ElectronicCats/badge_JSCON_2026/hardware/Footprints/3D/2479--3DModel-STEP-630548.STEP

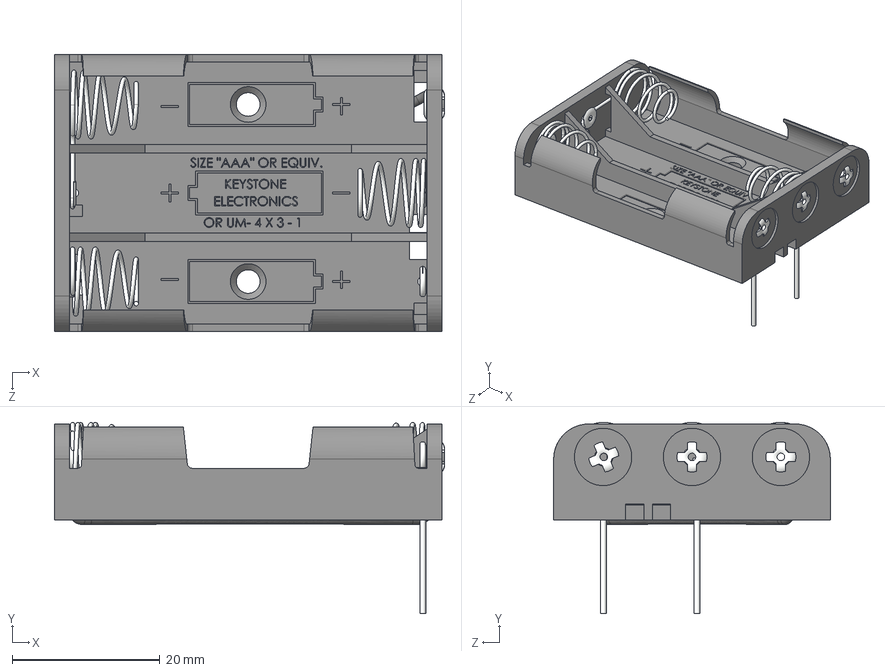
[picture p3: CAD file, 2026-06-18]
hardware/Footprints/3D/2479--3DModel-STEP-630548.STEP
52.9 x 25.9 x 37.5 mm
