ElectronicCats/badge_JSCON_2026/hardware/Badge_JSCON_2026.kicad_pcb

## KiCad design hardware/Badge_JSCON_2026.kicad_pcb (2026-06-30)

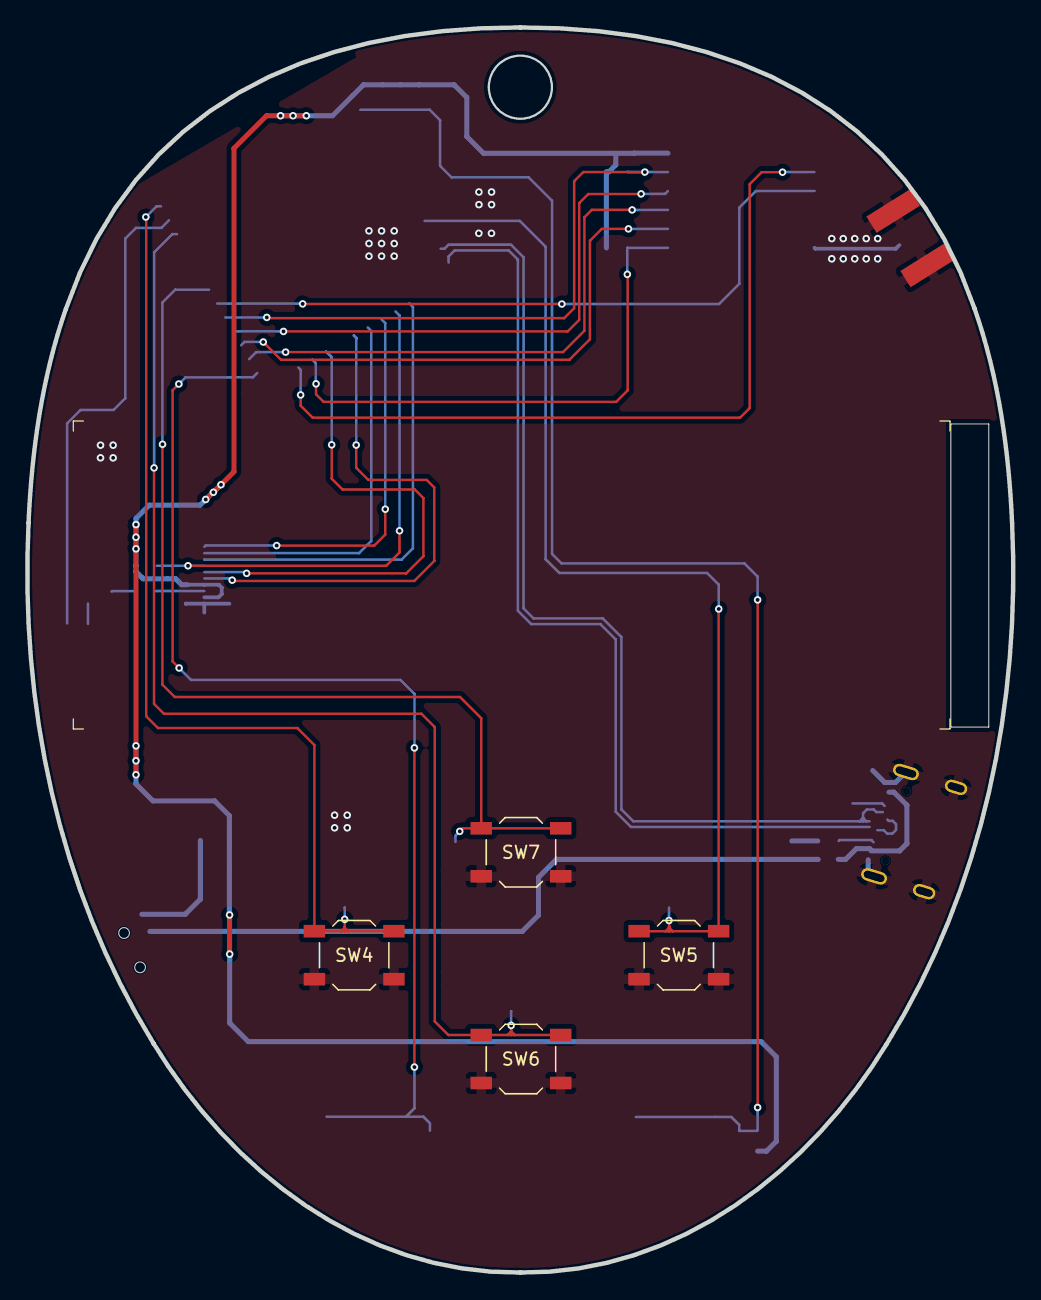
[picture p4: board Badge_JSCON_2026.kicad_pcb from above]

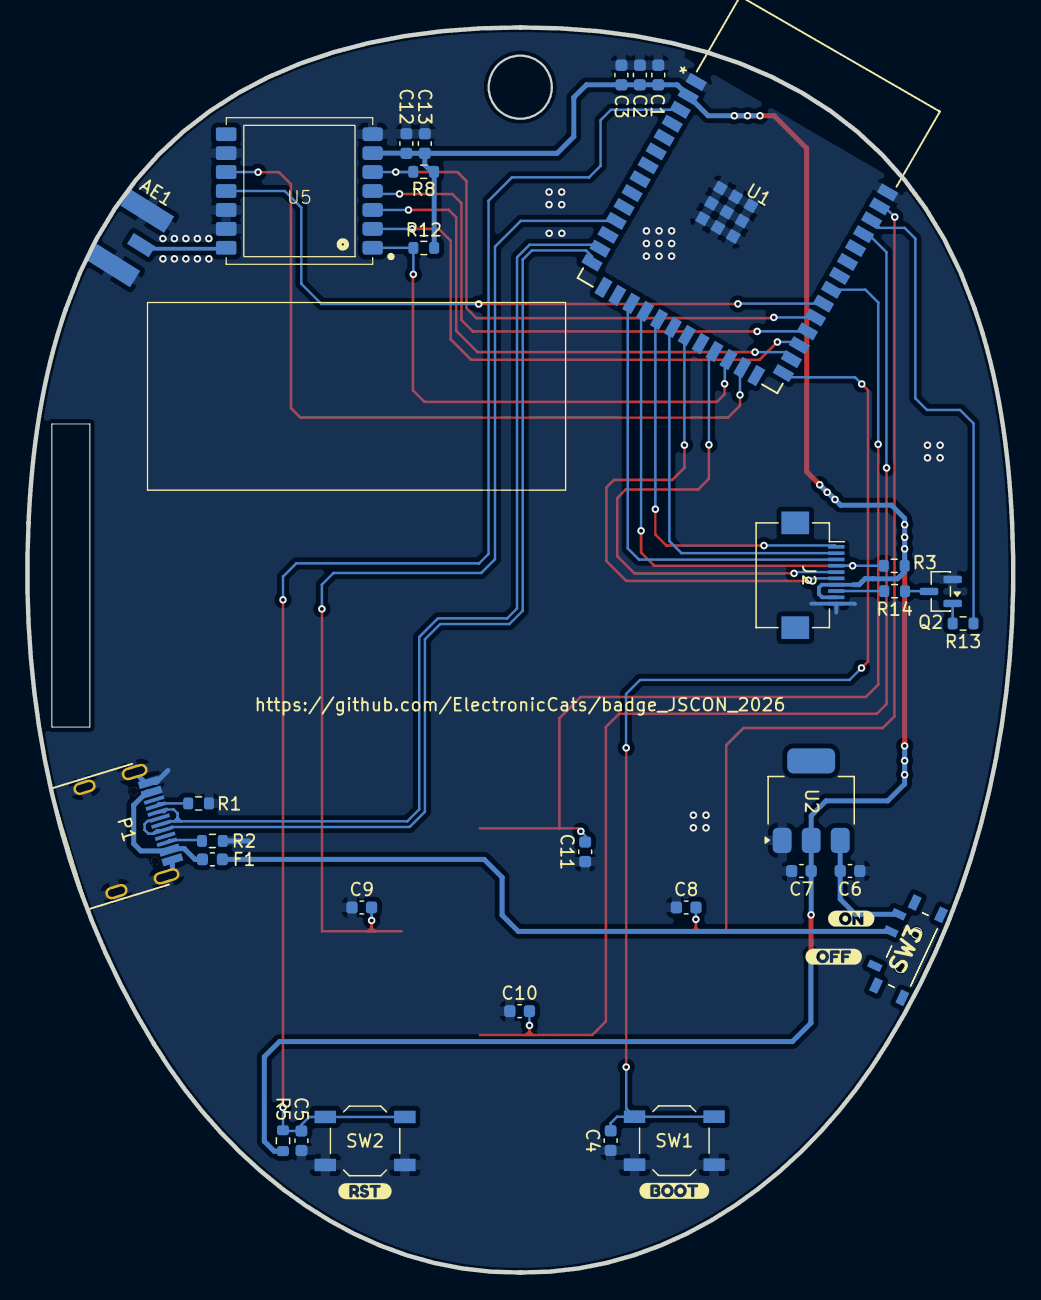
[picture p5: board Badge_JSCON_2026.kicad_pcb from below]

Board: 2 copper layers, 78.1 x 98.6 mm, 40 parts (36 on the bottom side), 33 nets.

Parts:
AE1: Antenna_Shield; SMA_EDGE
C1: 1uF; C_0603_1608Metric
C2, C3, C6, C7, C13: 10uF; C_0603_1608Metric
C4, C5, C8, C9, C10, C11: 0.1uF; C_0603_1608Metric
C12: 100nF; C_0603_1608Metric
F1: 0.75A; Fuse_0603_1608Metric
J2: LCD; Hirose_FH12-10S-0.5SH_1x10-1MP_P0.50mm_Horizontal
P1: USB_C_Plug_USB2.0; C393939
Q2: BC846; SOT-23
R1, R2: 5k1; R_0603_1608Metric
R3, R5, R8, R12: 10K; R_0603_1608Metric
R13: 1K; R_0603_1608Metric
R14: 3.9r; R_0603_1608Metric
SW1, SW2, SW4, SW5, SW6, SW7: SW_SPST_TL3342
SW3: ON; MSK12C02
U1: ESP32-S3-WROOM-1-N8; ESP32-S3-WROOM-1_EXP
U2: BL8072CLTR33; SOT-223
U5: VGdd79S915N0S1
kibuzzard-6A3B026D: G***; kibuzzard-6A3B026D
kibuzzard-6A3B0259: G***; kibuzzard-6A3B0259
kibuzzard-6A3B0260: G***; kibuzzard-6A3B0260
kibuzzard-6A3B0265: G***; kibuzzard-6A3B0265

Connections:
+3.3V: C1.1, C2.1, C3.1, C7.1, C12.1, C13.1, J2.7, J2.9, R3.2, R5.2, R8.2, R12.2, U1.2 (3V3), U2.2 (VO), U5.6 (VCC)
/BOOT: C4.2, SW1.2, U1.27 (IO0)
/BUSY: U1.32 (IO39), U5.11 (BUSY)
/CS0: R8.1, U1.31 (IO38), U5.5 (NSS)
/CS1: J2.4, R3.1, U1.18 (IO10)
/D+: P1.A6 (D+), U1.14 (IO20)
/D-: P1.A7 (D-), U1.13 (IO19)
/DIO: U1.25 (IO48), U5.10 (DIO1)
/DOWN: C10.2, SW6.2, U1.37 (TXD0)
/EN: C5.2, R5.1, SW2.2, U1.3 (EN)
/LCD_BRIGHT: R13.1, U1.38 (IO2)
/LEDK: J2.8, R14.2
/LEFT: C8.2, SW4.2, U1.39 (IO1)
/MISO: U1.29 (IO36), U5.2 (MISO)
/MOSI: U1.28 (IO35), U5.3 (MOSI)
/RIGHT: C9.2, SW5.2, U1.11 (IO18)
/RS: J2.3, U1.17 (IO9)
/RST: R12.1, U1.24 (IO47), U5.1 (RST)
/RSTB: J2.5, U1.23 (IO21)
/SCK: U1.30 (IO37), U5.4 (SCK)
/SPI_MOSI: J2.1, U1.19 (IO11)
/SPI_SCLK: J2.2, U1.20 (IO12)
/TE: J2.6, U1.21 (IO13)
/UP: C11.2, SW7.2, U1.33 (IO40)
GND: AE1.2 (Shield), C1.2, C2.2, C3.2, C4.1, C5.1, C6.2, C7.2, C8.1, C9.1, C10.1, C11.1, C12.2, C13.2, J2.10, P1.A1 (GND), P1.S1 (SHIELD), Q2.2 (E), R1.1, R2.1, SW1.1, SW2.1, SW4.1, SW5.1, SW6.1, SW7.1, U1.1 (GND), U1.40 (GND), U1.41 (GND), U1.42 (GND), U1.43 (GND), U1.44 (GND), U1.45 (GND), U1.46 (GND), U1.47 (GND), U1.48 (GND), U1.49 (GND), U2.1 (GND), U5.7 (GND), U5.9 (GND), U5.12 (GND), U5.13 (GND)
unnamed: AE1.1 (A), U5.14 (ANT)
unnamed: F1.1, P1.A4 (VBUS)
unnamed: P1.A5 (CC), R1.2
unnamed: P1.B5 (VCONN), R2.2
unnamed: Q2.1 (B), R13.2
unnamed: Q2.3 (C), R14.1
unnamed: C6.1, SW3.3 (A), U2.3 (VI)
VBUS: F1.2, SW3.2 (B)
