ElectronicCats/badge_JSCON_2026/(commit log)

2026-06-30 fix: resistor 10k price
2026-10-27 docs: README del badge JSCONF 2026 con base en la plantilla
